Rathioz/PE2_Tank/Altium/PCB_Project/PE2_RC_Tank.pdf

5 | | 6 SWCL K


1 8
1 9
2 1

1 1
1 7


1 8
1 9
2 1

1 1
1 7


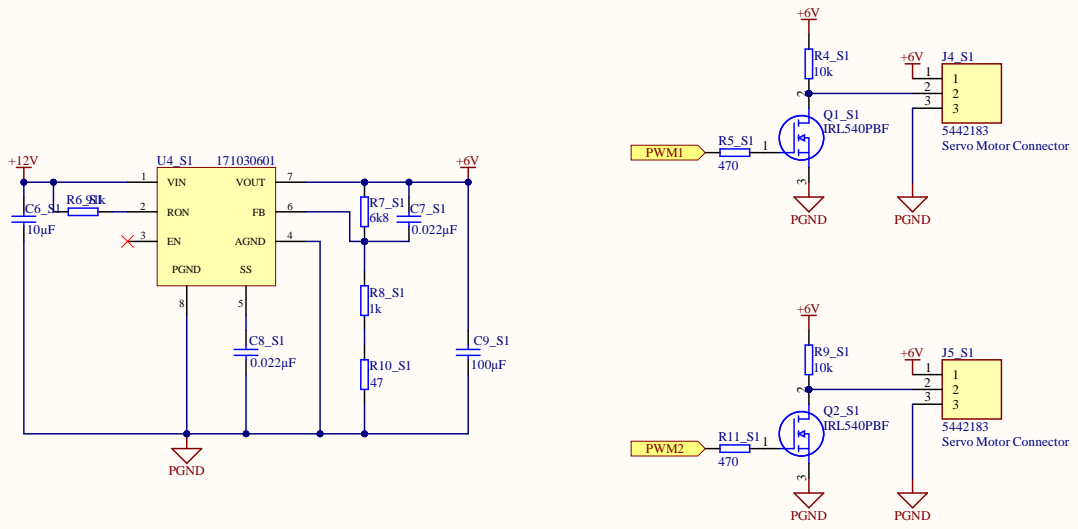
[picture p14: page 5]

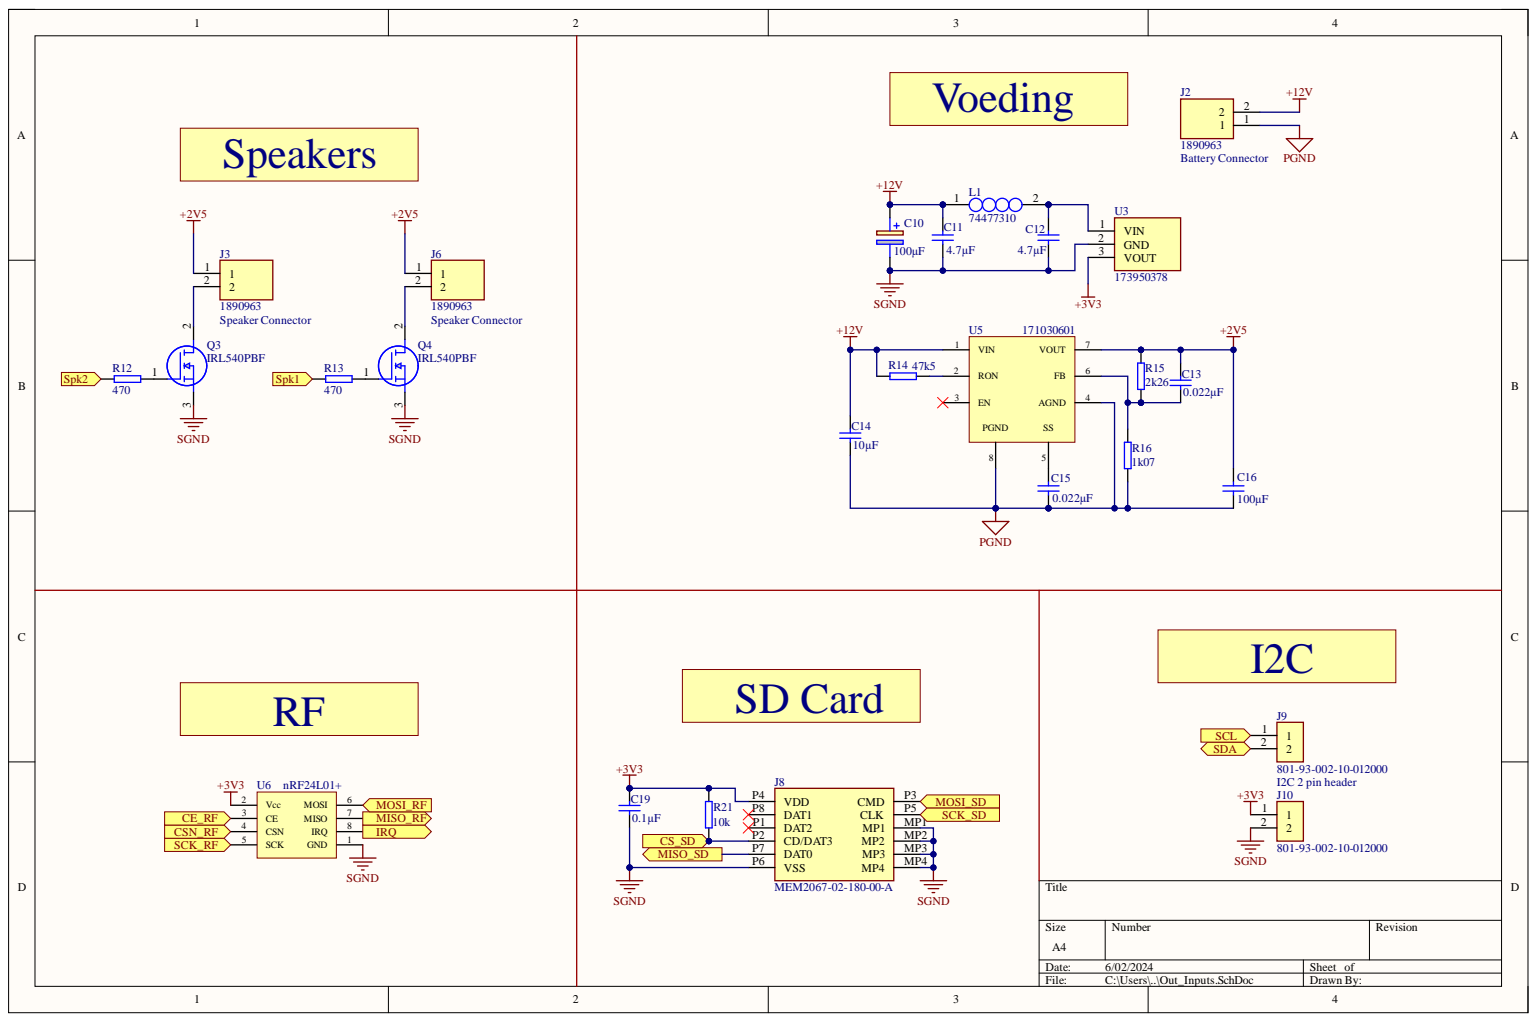
[picture p15: page 6]
