Rathioz/PE2_Tank/(list of files, drawings)

Other design files:
Altium/PCB_Project/Main_Board_Tank.SchDoc
Altium/PCB_Project/Motor_Driver.SchDoc
Altium/PCB_Project/Out_Inputs.SchDoc
Altium/PCB_Project/PE2_RC_Tank.PrjPcb
Altium/PCB_Project/Servo_Driver.SchDoc
Altium/PE2_RC_Controller/Main_Board_Controller.SchDoc
Altium/PE2_RC_Controller/Out_Inputs.SchDoc
Altium/PE2_RC_Controller/PE2_RC_Controller.PrjPcb
