Rathioz/PE2_Tank/PE2_Tank.ioc

Mcu.UserName=STM32F301C8Tx
PA0.Signal=S_TIM2_CH1_ETR
PA10.GPIO_Label=PWM21
PA10.Signal=S_TIM1_CH3
PA11.GPIO_Label=PWM20
PA11.Signal=S_TIM1_CH4
PA12.Signal=GPXTI12
PA13.Signal=SYS_JTMS-SWDIO
PA14.Signal=SYS_JTCK-SWCLK
PA2.Signal=S_TIM15_CH1
PA3.Signal=S_TIM15_CH2
PA4.GPIO_Label=IN10
PA4.Signal=GPIO_Output
PA6.GPIO_Label=IN20
PA6.Signal=GPIO_Output
PA8.GPIO_Label=PWM10
PA8.Signal=S_TIM1_CH1
PA9.GPIO_Label=PWM11
PA9.Signal=S_TIM1_CH2
PB0.GPIO_Label=IN11
PB0.Signal=GPIO_Output
PB11.GPIO_Label=Battery
PB11.Signal=ADC1_IN14
PB2.GPIO_Label=IN21
PB2.Signal=GPIO_Output
PB3.Signal=SPI3_SCK
PB4.Signal=SPI3_MISO
PB5.Signal=SPI3_MOSI
PB6.Signal=GPIO_Output
PB7.Signal=GPIO_Output
PC13.Signal=GPXTI13
PF0-OSC_IN.Signal=RCC_OSC_IN
PF1-OSC_OUT.Signal=RCC_OSC_OUT
