Rathioz/PE2_Tank/Core/Inc/main.h

#define IN10_Pin GPIO_PIN_4
#define IN10_GPIO_Port GPIOA
#define IN20_Pin GPIO_PIN_6
#define IN20_GPIO_Port GPIOA
#define IN11_Pin GPIO_PIN_0
#define IN11_GPIO_Port GPIOB
#define IN21_Pin GPIO_PIN_2
#define IN21_GPIO_Port GPIOB
#define Battery_Pin GPIO_PIN_11
#define Battery_GPIO_Port GPIOB
#define PWM10_Pin GPIO_PIN_8
#define PWM10_GPIO_Port GPIOA
#define PWM11_Pin GPIO_PIN_9
#define PWM11_GPIO_Port GPIOA
#define PWM21_Pin GPIO_PIN_10
#define PWM21_GPIO_Port GPIOA
#define PWM20_Pin GPIO_PIN_11
#define PWM20_GPIO_Port GPIOA
